puginarug/GreenTemp/Images/WhatsApp Image 2022-07-06 at 11.14.14 AM.jpeg

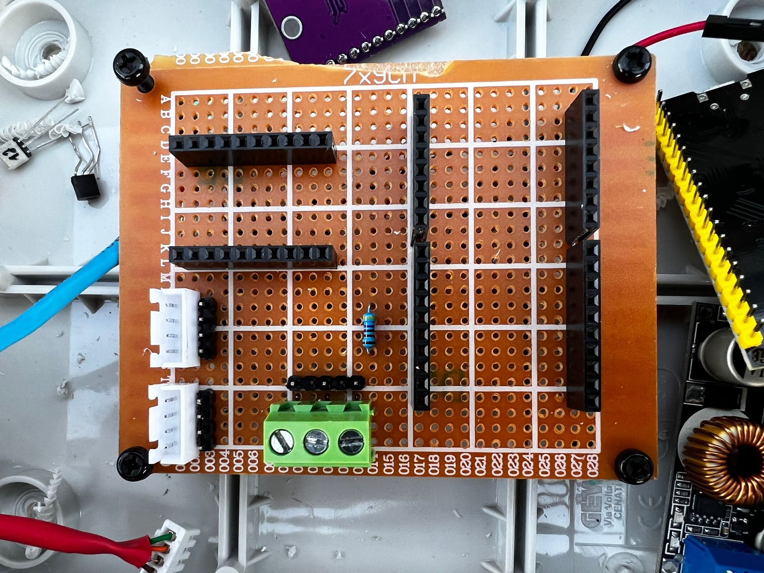
Images/WhatsApp Image 2022-07-06 at 11.14.14 AM.jpeg
