puginarug/GreenTemp/Images/WhatsApp Image 2022-07-06 at 11.14.12 AM (1).jpeg

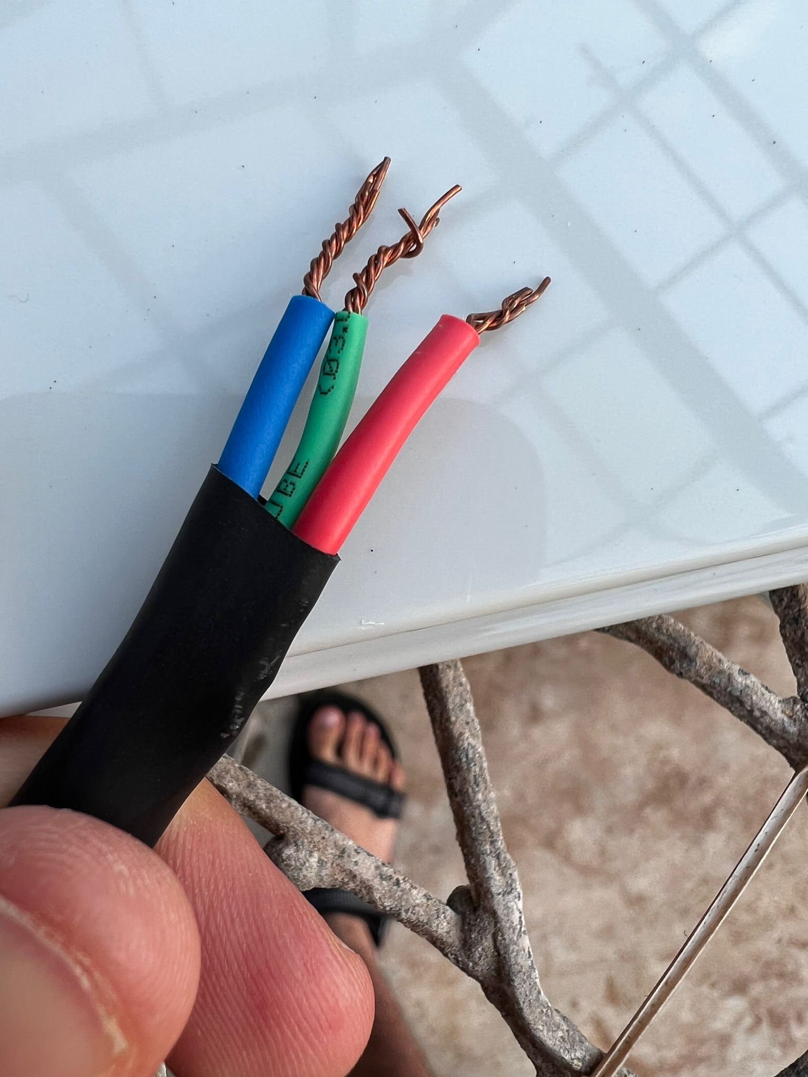
Images/WhatsApp Image 2022-07-06 at 11.14.12 AM (1).jpeg
