puginarug/GreenTemp/Site/Data-Analasys.md

# Data Analysis
All our data is available in the following ThingSpeak sites  (all sensors and comparison):
- <a href=https://thingspeak.com/channels/1777871> Box 1</a>
- <a href=https://thingspeak.com/channels/1766721> Box 2</a>
- <a href=https://thingspeak.com/channels/1777982> Box 3</a>

In those channels you can find a sensors raw data which looks like that:
<p align="center">

</p>
and a matlab comparison between all sensors of the station:
<p align="center">

</p>
the matlab code for the comparison is found here below:

```matlab
% Prior to running this MATLAB code template, assign the channel ID to read
% data from to the 'readChannelID' variable. Also, assign the field ID
% within the channel that you want to read data from to plot. 

% TODO - Replace the [] with channel ID to read data from:
readChannelID = [1777871];
% TODO - Replace the [] with the Field ID to read data from:
fieldID1 = [1,2,3,4,5,6];

% Channel Read API Key 
% If your channel is private, then enter the read API
% Key between the '' below: 
readAPIKey = 'C8XSRFSFYB0DHKAL';

%% Read Data (if you want more valeus then change it here %%

[data, time] = thingSpeakRead(readChannelID, 'Field', fieldID1, 'NumPoints', 8000, 'ReadKey', readAPIKey);

data(data == -127) = NaN;
%% Visualize Data %%

plot(time, data);

%% Lable name %%
ylabel('Temperature (c)') 

%% Legend name %%
legend({'sht1 ','sht2 ','ds1-15','ds1-11','ds1-13','ds1-14'},'Location','northwest')

%% Grid %%
grid on
grid minor

%ylim([-1 37])
```

In order to get a 3d plot containing the current temperatures from all the sensor, run the code from the attached file: 'Agtech_final_project_3D_Temp_plotting'.
or copy the code below: 
```Python
import urllib.request
import matplotlib.pyplot as plt
import numpy as np
import pandas as pd
from matplotlib import cm
from mpl_toolkits.mplot3d import Axes3D
from mpl_toolkits.mplot3d.art3d import Poly3DCollection
#from scipy.signal import savgol_filter

# define names of files
filename1 = "Station1.csv"
filename2 = "Station2.csv"
filename3 = "Station3.csv"

# define what to download
channels1 = "1777871"
channels2="1766721"
channels3="1777982"
fields = "1,2,3,4,5,6"
minutes = "1"

# download using Thingspeak's API 1
url = f"https://api.thingspeak.com/channels/{channels1}/fields/{fields}.csv?minutes={minutes}"
data = urllib.request.urlopen(url)
d = data.read()

# save data to csv
file = open(filename1, "w")
file.write(d.decode('UTF-8'))
file.close()

# download using Thingspeak's API 2
url = f"https://api.thingspeak.com/channels/{channels2}/fields/{fields}.csv?minutes={minutes}"
data = urllib.request.urlopen(url)
d = data.read()

# save data to csv
file = open(filename2, "w")
file.write(d.decode('UTF-8'))
file.close()

# download using Thingspeak's API 3
url = f"https://api.thingspeak.com/channels/{channels3}/fields/{fields}.csv?minutes={minutes}"
data = urllib.request.urlopen(url)
d = data.read()

# save data to csv
file = open(filename3, "w")
file.write(d.decode('UTF-8'))
file.close()

# opening files as data frames
station1 = pd.read_csv("Station1.csv")
station2 = pd.read_csv("Station2.csv")
station3 = pd.read_csv("Station3.csv")

# defining the file containing all average tempartures and sensor locations (the main file)
filename4 = "Final Sensor Locations & Measurments.csv"
df4 = pd.read_csv(filename4)

# calculating mean temp for each sensor
avg_box1_sht1 = station1['field1'].mean()
avg_box1_sht2 = station1['field2'].mean()
avg_box1_ds1_15 = station1['field3'].mean()
avg_box1_ds1_11 = station1['field4'].mean()
avg_box1_ds1_13 = station1['field5'].mean()
avg_box1_ds1_14 = station1['field6'].mean()
avg_box2_sht1 = station2['field1'].mean()
avg_box2_sht2 = station2['field2'].mean()
avg_box2_ds1_7 = station2['field3'].mean()
avg_box2_ds1_8 = station2['field4'].mean()
avg_box2_ds1_9 = station2['field5'].mean()
avg_box2_ds1_10 = station2['field6'].mean()
avg_box3_sht1 = station3['field1'].mean()
avg_box3_sht2 = station3['field2'].mean()
avg_box3_ds1_16 = station3['field3'].mean()
avg_box3_ds1_18 = station3['field4'].mean()
avg_box3_ds1_17 = station3['field5'].mean()
avg_box3_ds1_19 = station3['field6'].mean()

# creating a list of all the means
mean_list = [avg_box1_sht1, avg_box1_sht2, avg_box1_ds1_15, avg_box1_ds1_11, avg_box1_ds1_13,
             avg_box1_ds1_14, avg_box2_sht1, avg_box2_sht2, avg_box2_ds1_7, avg_box2_ds1_8,
             avg_box2_ds1_9, avg_box2_ds1_10, avg_box3_sht1, avg_box3_sht2, avg_box3_ds1_16,
             avg_box3_ds1_18, avg_box3_ds1_17, avg_box3_ds1_19]

# updating the main file
df4['temp_c'] = mean_list
# replacing negative temp reads with 'nan'
df4['temp_c']=df4['temp_c'].mask(df4['temp_c'].gt(60) | df4['temp_c'].lt(0), np.nan)

# creating the 3d graph

fig = plt.figure(figsize=(10,5))
ax = Axes3D(fig)

#code for plotting the greenhouse was taken from Amir Shefer: 
#walls (read as a matrix, every colums is a position vector for the polygon corner)
x =  [0,0,0,  0],      [15,15,15,15],[15,0,0,15],  [15,0,0,15]
y = [0,0,6.5,6.5]  , [0,6.5,6.5,0],[0,0,0,0],    [6.5,6.5,6.5,6.5]
z =  [0,  2.1,2.1,0], [0,0,2.1,2.1],[0,0,2.1,2.1],[0,0,2.1,2.1]

surfaces = []

for i in range(len(x)):
    surfaces.append( [list(zip(x[i],y[i],z[i]))] )

for surface in surfaces:
    ax.add_collection3d(Poly3DCollection(surface,ec='b',fc=(0, 0, 0, 0)))

#roof
x = [15,0,0,15],     [0,15,15,0],          [0,0,0],[15,15,15]
y = [0,0,3.25, 3.25],[6.5,6.5,3.25,3.25],  [0,3.25,6.5],[0,3.25,6.5]
z = [2.1,2.1,3.5,3.5],   [2.1,2.1,3.5,3.5],        [2.1,3.5,2.1],[2.1,3.5,2.1]

surfaces = []

for i in range(len(x)):
    surfaces.append( [list(zip(x[i],y[i],z[i]))] )

for surface in surfaces:
    ax.add_collection3d(Poly3DCollection(surface,ec='r',fc=(0., 0., 0., 0.)))

ax.set_xlim(0,16)    
ax.set_ylim(0,8)    
ax.set_zlim(0,4)    

ax.legend(loc=(-0.4,0.1))
plt.rcParams['grid.color'] = (0.5, 0.5, 0.5, 0)

#sensors
x = df4.lengh_m
y = df4.width_m
z = df4.hight_m
t = df4.temp_c

surf = ax.plot_trisurf(x, y, z, cmap=cm.coolwarm, linewidth=0)

img = ax.scatter(x, y, z, c=t, cmap=plt.get_cmap("plasma"))
fig.colorbar(img)

ax.set_xlabel('$length$')
ax.set_ylabel('$width$')
ax.set_zlabel('$hight$')

#plt.legend(loc="upper left")

plt.show()
```
Examples for some 3d plots generated by the code:

<p align="center">
the greennhouse at 10:15

the greennhouse at 13:00

the greennhouse at 16:30
