puginarug/GreenTemp/Images/giphy.gif

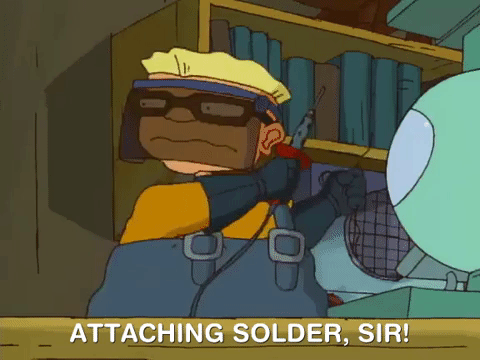
Images/giphy.gif
