puginarug/GreenTemp/Images/naked board.jpg

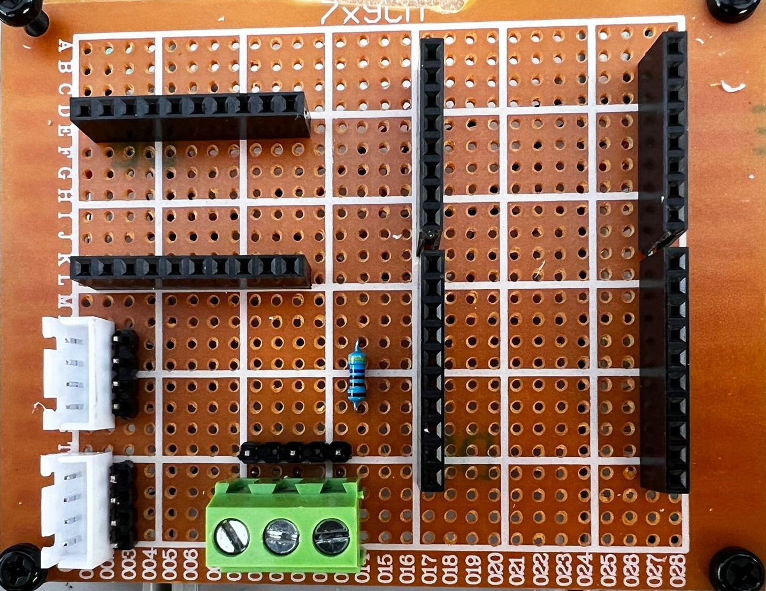
Images/naked board.jpg
