puginarug/GreenTemp/Images/our circuit.jpg

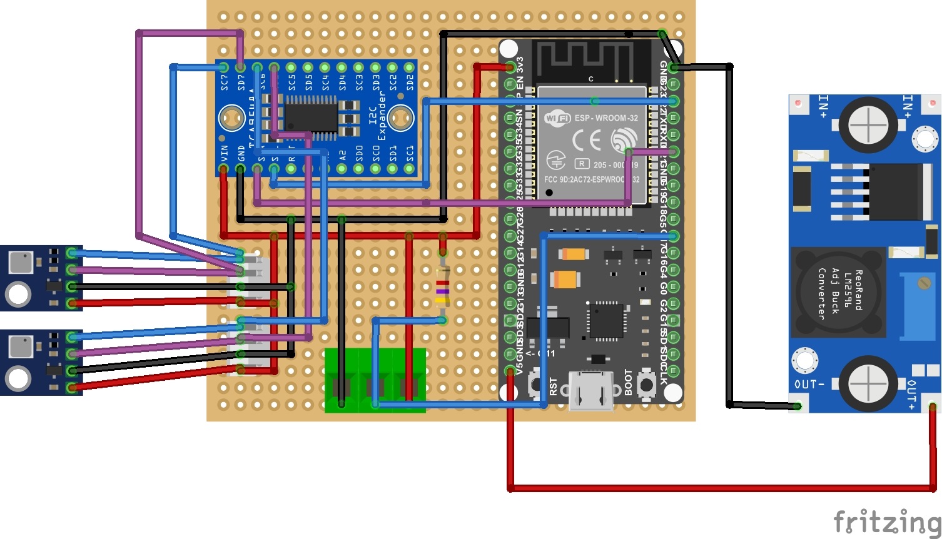
Images/our circuit.jpg
