puginarug/GreenTemp/Images/WhatsApp Image 2022-06-30 at 9.39.48 AM.jpeg

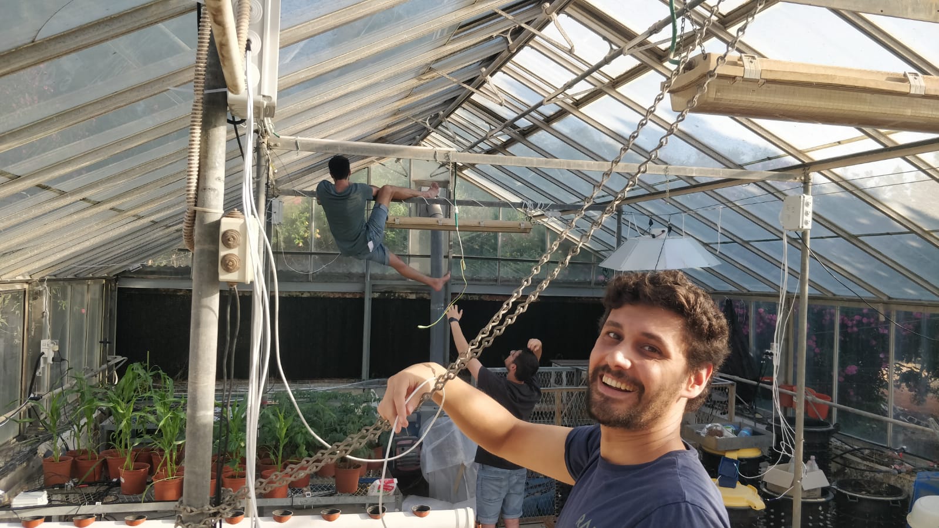
Images/WhatsApp Image 2022-06-30 at 9.39.48 AM.jpeg
