puginarug/GreenTemp/Images/WhatsApp Image 2022-06-30 at 12.05.59 AM.jpeg

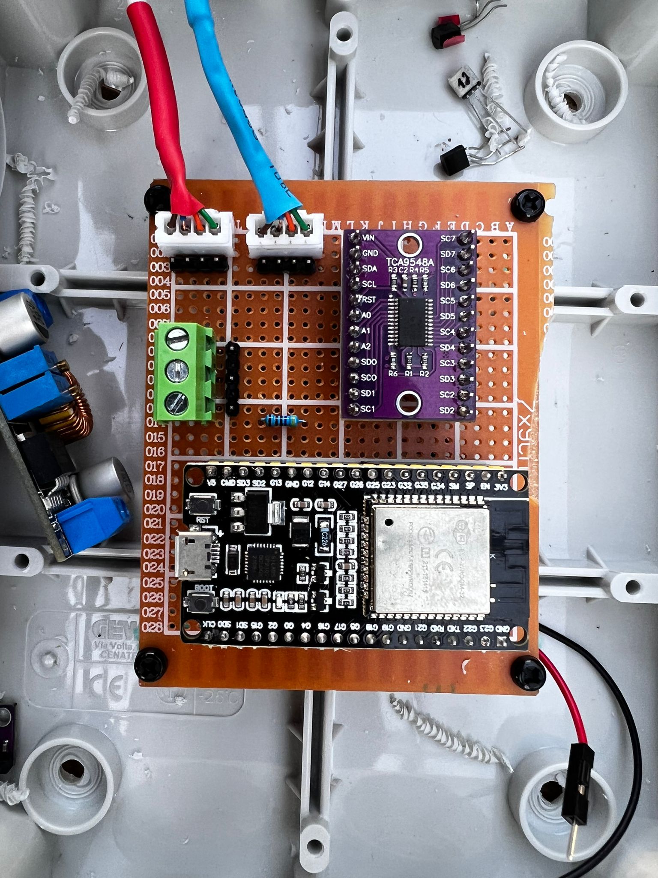
Images/WhatsApp Image 2022-06-30 at 12.05.59 AM.jpeg
