puginarug/GreenTemp/Images/WhatsApp Image 2022-06-30 at 12.06.00 AM.jpeg

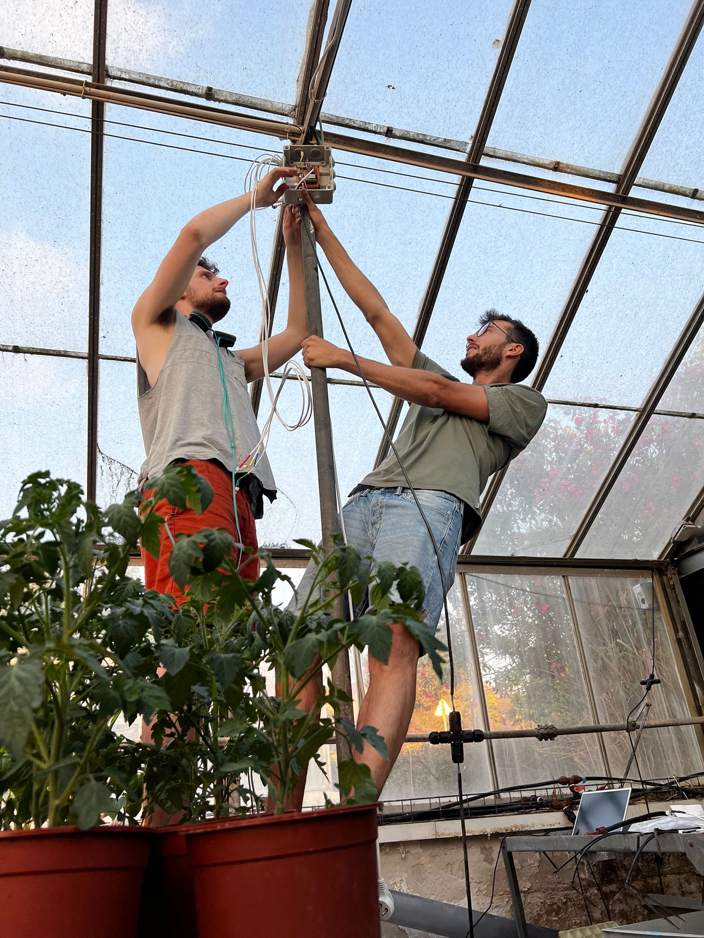
Images/WhatsApp Image 2022-06-30 at 12.06.00 AM.jpeg
