puginarug/GreenTemp/Images/WhatsApp Image 2022-06-30 at 12.06.01 AM.jpeg

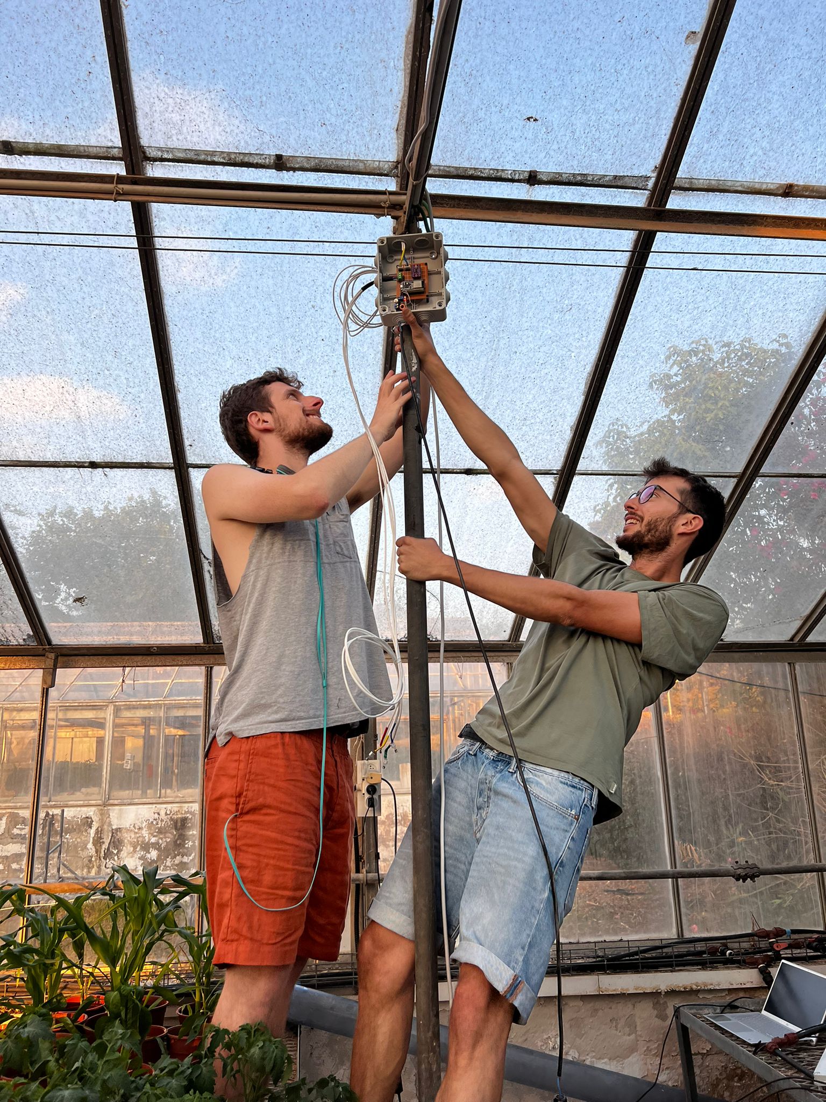
Images/WhatsApp Image 2022-06-30 at 12.06.01 AM.jpeg
