puginarug/GreenTemp/(commit log)

2022-07-05 Add files via upload
    This file contains locations, IDs and channel number for every sensor.
    [Final Sensor Locations & Measurments.CSV]
2022-07-17 Organizing in folders
    [Final Sensor Locations & Measurments.CSV]
